buserror/bluepill_scsi/kicad/bluepill_scsi.kicad_pcb

## KiCad design kicad/bluepill_scsi.kicad_pcb (2020-07-09)

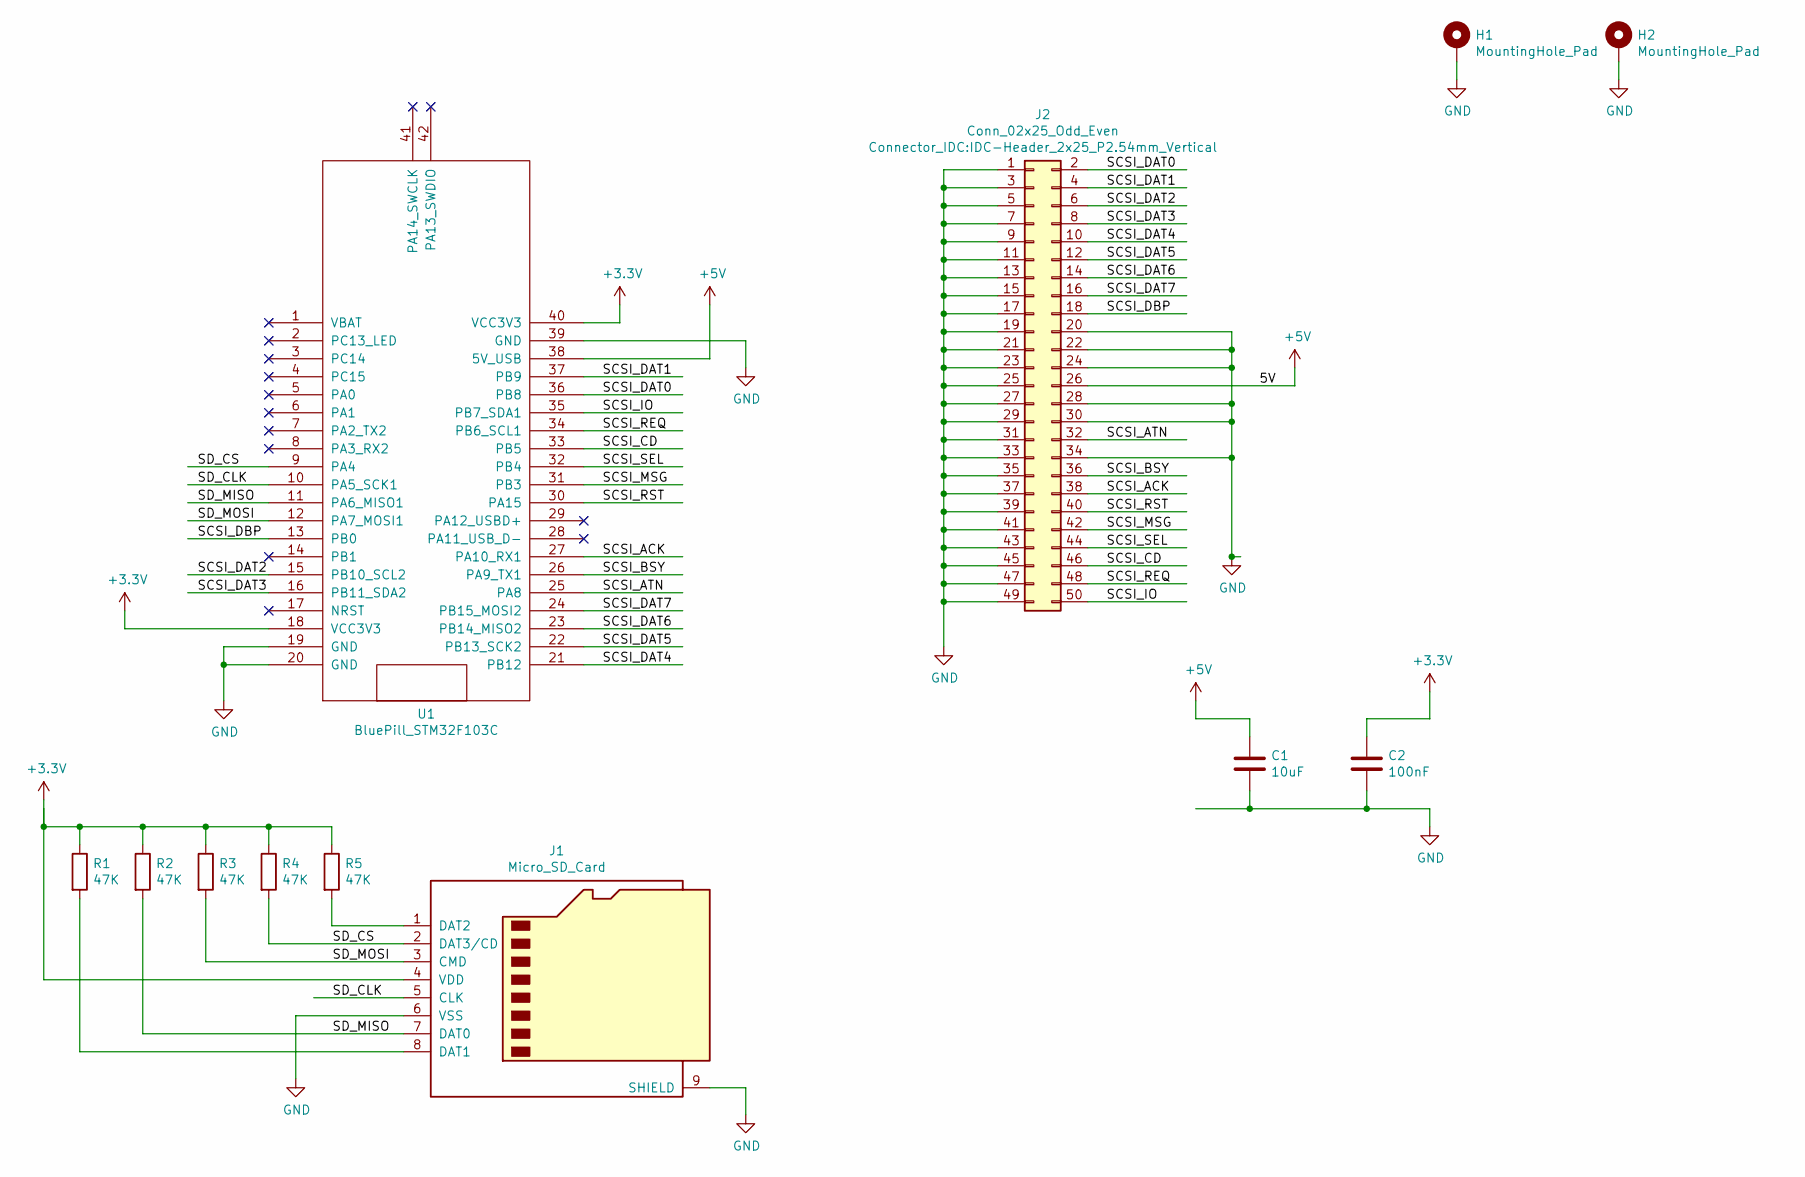
[picture p1: schematic bluepill_scsi.sch]

Parts:
C1: 10uF; C_0805_2012Metric
C2: 100nF; C_0603_1608Metric
H1, H2: MountingHole_Pad; MountingHole_2.7mm_M2.5
J1: Micro_SD_Card; microSD_HC_Molex_104031-0811
J2: Conn_02x25_Odd_Even; IDC-Header_2x25_P2.54mm_Vertical
R1, R2, R3, R4, R5: 47K; R_0603_1608Metric_Pad1.05x0.95mm_HandSolder
U1: BluePill_STM32F103C

Connections:
+3V3: C2.1, J1.4 (VDD), R1.1, R2.1, R3.1, R4.1, R5.1, U1.18 (VCC3V3), U1.40 (VCC3V3)
+5V: C1.1, J2.26, U1.38 (5V_USB)
/SCSI_ACK: J2.38, U1.27 (PA10_RX1)
/SCSI_ATN: J2.32, U1.25 (PA8)
/SCSI_BSY: J2.36, U1.26 (PA9_TX1)
/SCSI_CD: J2.46, U1.33 (PB5)
/SCSI_DAT0: J2.2, U1.36 (PB8)
/SCSI_DAT1: J2.4, U1.37 (PB9)
/SCSI_DAT2: J2.6, U1.15 (PB10_SCL2)
/SCSI_DAT3: J2.8, U1.16 (PB11_SDA2)
/SCSI_DAT4: J2.10, U1.21 (PB12)
/SCSI_DAT5: J2.12, U1.22 (PB13_SCK2)
/SCSI_DAT6: J2.14, U1.23 (PB14_MISO2)
/SCSI_DAT7: J2.16, U1.24 (PB15_MOSI2)
/SCSI_DBP: J2.18, U1.13 (PB0)
/SCSI_IO: J2.50, U1.35 (PB7_SDA1)
/SCSI_MSG: J2.42, U1.31 (PB3)
/SCSI_REQ: J2.48, U1.34 (PB6_SCL1)
/SCSI_RST: J2.40, U1.30 (PA15)
/SCSI_SEL: J2.44, U1.32 (PB4)
/SD_CLK: J1.5 (CLK), U1.10 (PA5_SCK1)
/SD_CS: J1.2 (DAT3/CD), R4.2, U1.9 (PA4)
/SD_MISO: J1.7 (DAT0), R2.2, U1.11 (PA6_MISO1)
/SD_MOSI: J1.3 (CMD), R3.2, U1.12 (PA7_MOSI1)
GND: C1.2, C2.2, H1.1, H2.1, J1.6 (VSS), J1.9 (SHIELD), J2.1, J2.3, J2.5, J2.7, J2.9, J2.11, J2.13, J2.15, J2.17, J2.19, J2.20, J2.21, J2.22, J2.23, J2.24, J2.25, J2.27, J2.28, J2.29, J2.30, J2.31, J2.33, J2.34, J2.35, J2.37, J2.39, J2.41, J2.43, J2.45, J2.47, J2.49, U1.19 (GND), U1.20 (GND), U1.39 (GND)
unnamed: J1.1 (DAT2), R5.2
unnamed: J1.8 (DAT1), R1.2

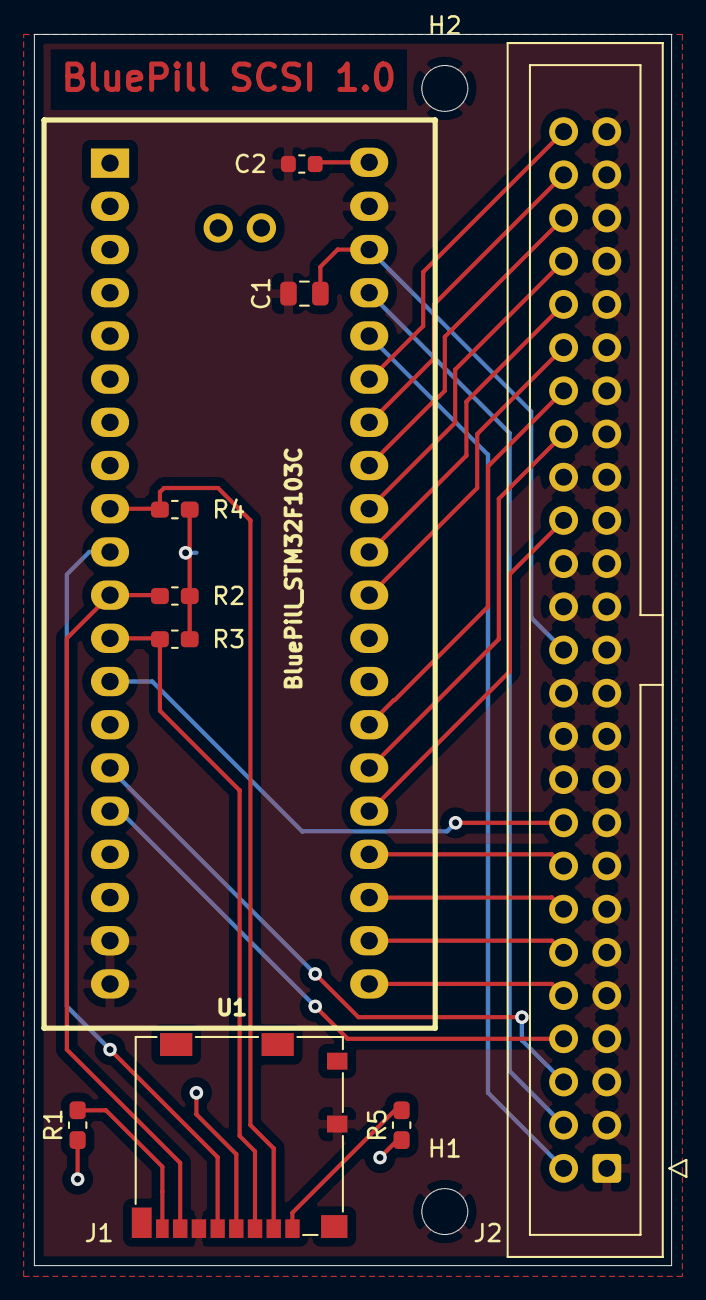
[picture p2: board bluepill_scsi.kicad_pcb from above]

Board: 2 copper layers, 37.5 x 72.4 mm, 12 parts (0 on the bottom side), 27 nets.
